ilindov/YarisSpeedDoorLock/RaspberryPi/_Schematic/IMG_0890.jpg

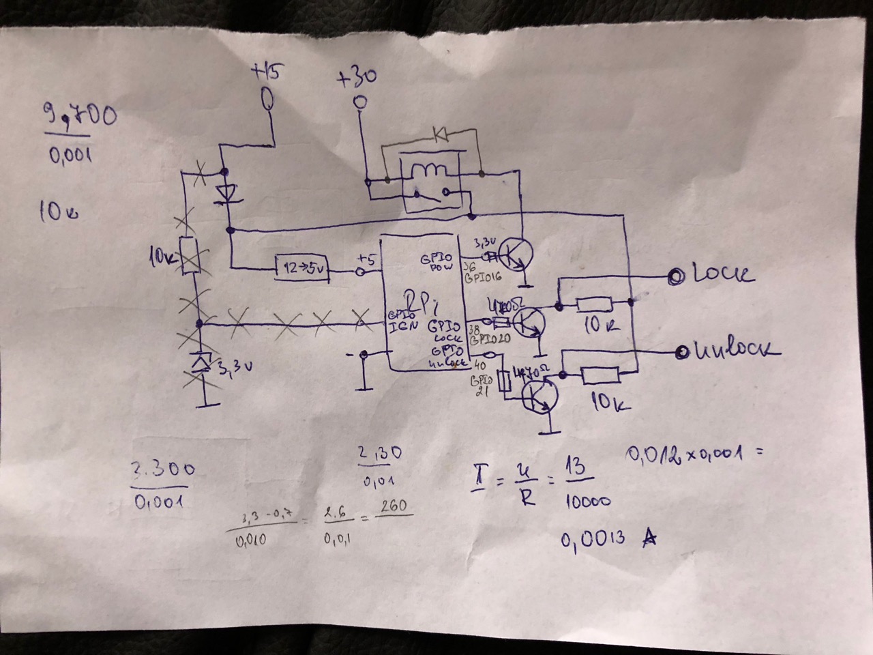
RaspberryPi/_Schematic/IMG_0890.jpg
