ilindov/YarisSpeedDoorLock/Arduino/YarisSpeedDoorLock/_Schematic&PCB/Yaris speed door lock-ext power and relays.brd

## EAGLE design Arduino/YarisSpeedDoorLock/_Schematic&PCB/Yaris speed door lock-ext power and relays.brd (2019-01-16)

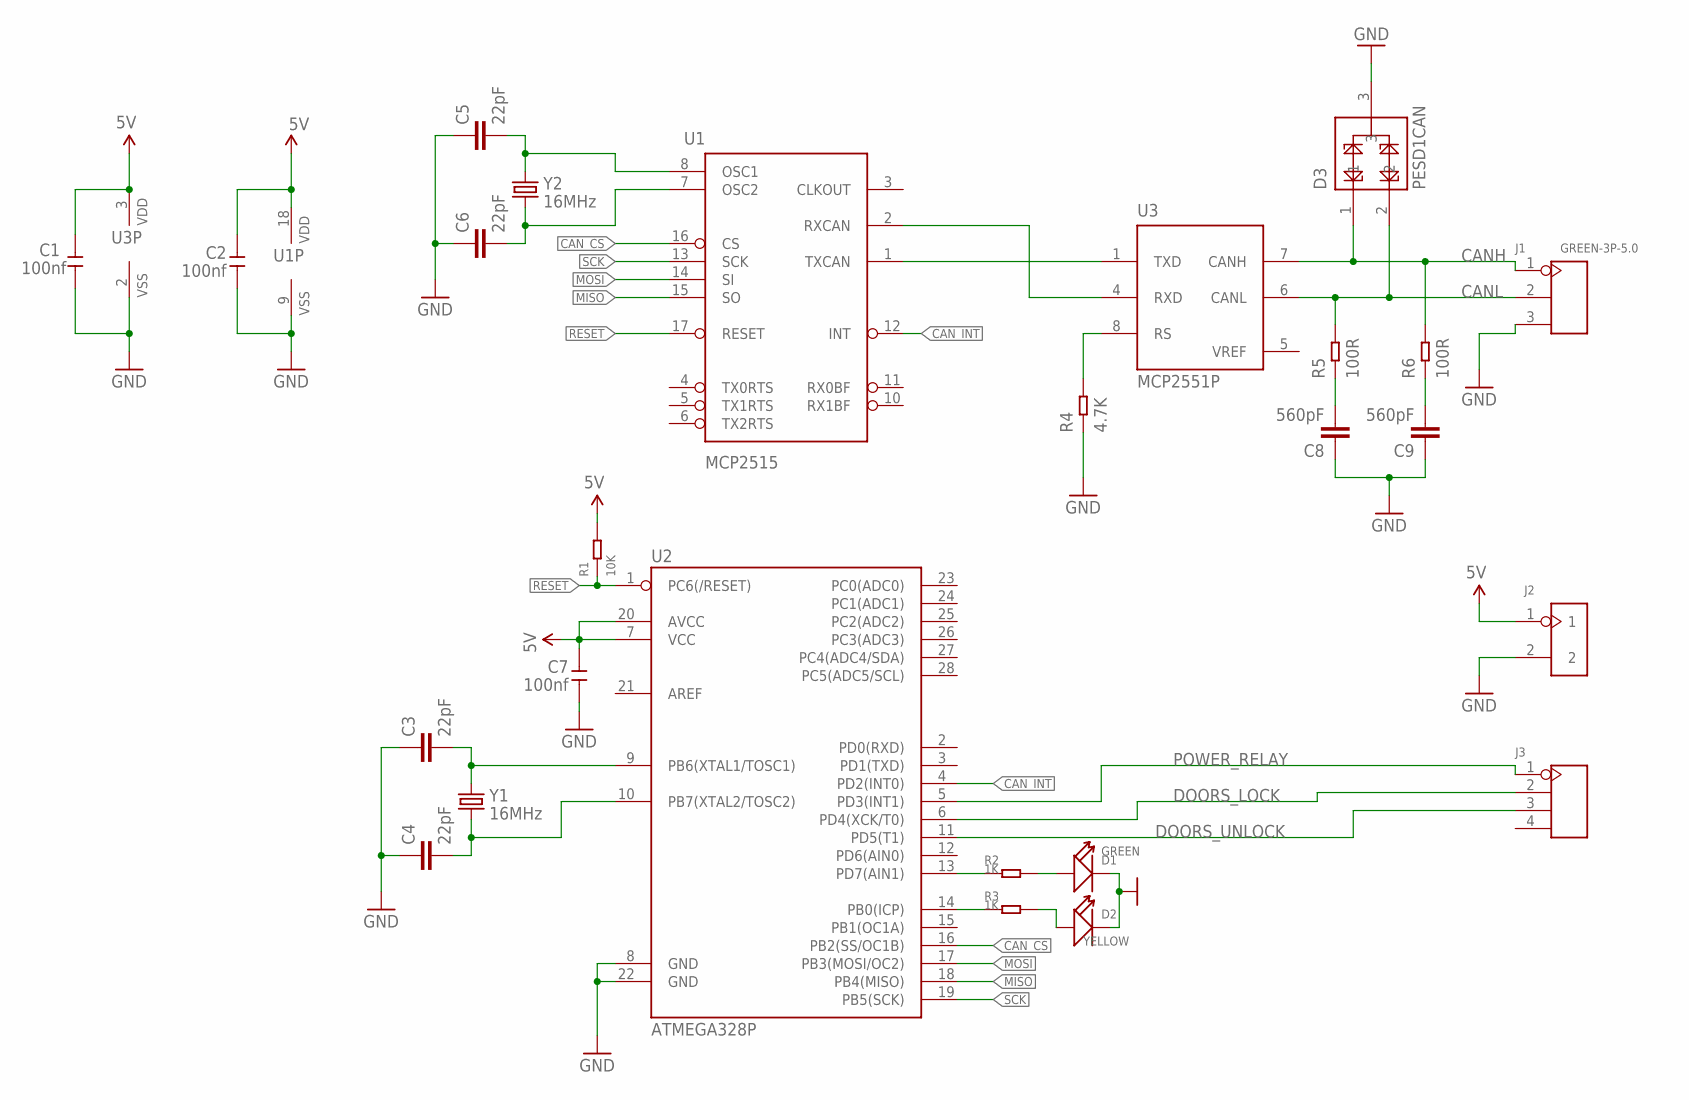
[picture p2: schematic Yaris speed door lock-ext power and relays.sch]

Parts:
C1, C2, C7: 100nf; CERAMIC-2.54
C3, C4, C5, C6: 22pF; CAP-PTH-2.54
C8, C9: 560pF; 0603-CAP
D1: GREEN; LED2-2.54-D3.0MM
D2: YELLOW; LED2-2.54-D3.0MM
D3: PESD1CAN; SOT23-3
J1: GREEN-3P-5.0; H3-5.0-15.5X8.0MM
J2: DIP-BLACK-JUMPER; H2-2.54
J3: DIP-BLACK-FEMALE-HEADER-VERT(4P-2.54); H4-2.54
R1: 10K; PR-D2.3XL6.5MM
R2, R3: 1K; PR-D2.3XL6.5MM
R4: 4.7K; PR-D2.3XL6.5MM
R5, R6: 100R; PR-D2.3XL6.5MM
U1: MCP2515; SO-18W
U2: ATMEGA328P; DIP28
U3: MCP2551P; DIL8
Y1, Y2: 16MHz; HC49US

Connections:
5V: C1.2, C2.2, C7.2, J2.1, R1.2, U1.18 (VDD), U2.7 (VCC), U2.20 (AVCC), U3.3 (VDD)
CANH: D3.1, J1.1, R6.2, U3.7 (CANH)
CANL: D3.2, J1.2, R5.2, U3.6 (CANL)
CAN_CS: U1.16 (CS), U2.16 (PB2(SS/OC1B))
CAN_INT: U1.12 (INT), U2.4 (PD2(INT0))
CAN_RXD: U1.2 (RXCAN), U3.4 (RXD)
CAN_TXD: U1.1 (TXCAN), U3.1 (TXD)
DOORS_LOCK: J3.2, U2.6 (PD4(XCK/T0))
DOORS_UNLOCK: J3.3, U2.11 (PD5(T1))
GND: C1.1, C2.1, C3.1, C4.1, C5.1, C6.1, C7.1, C8.1, C9.1, D1.K (-), D2.K (-), D3.3, J1.3, J2.2, R4.1, U1.9 (VSS), U2.8 (GND), U2.22 (GND), U3.2 (VSS)
MISO: U1.15 (SO), U2.18 (PB4(MISO))
MOSI: U1.14 (SI), U2.17 (PB3(MOSI/OC2))
unnamed: C3.2, U2.9 (PB6(XTAL1/TOSC1)), Y1.2
unnamed: C4.2, U2.10 (PB7(XTAL2/TOSC2)), Y1.1
unnamed: C8.2, R5.1
unnamed: C9.2, R6.1
unnamed: R2.1, U2.13 (PD7(AIN1))
unnamed: R4.2, U3.8 (RS)
unnamed: R3.1, U2.14 (PB0(ICP))
unnamed: D1.A (+), R2.2
unnamed: C5.2, U1.8 (OSC1), Y2.2
unnamed: C6.2, U1.7 (OSC2), Y2.1
unnamed: D2.A (+), R3.2
POWER_RELAY: J3.1, U2.5 (PD3(INT1))
RESET: R1.1, U1.17 (RESET), U2.1 (PC6(/RESET))
SCK: U1.13 (SCK), U2.19 (PB5(SCK))
VREF: U3.5 (VREF)

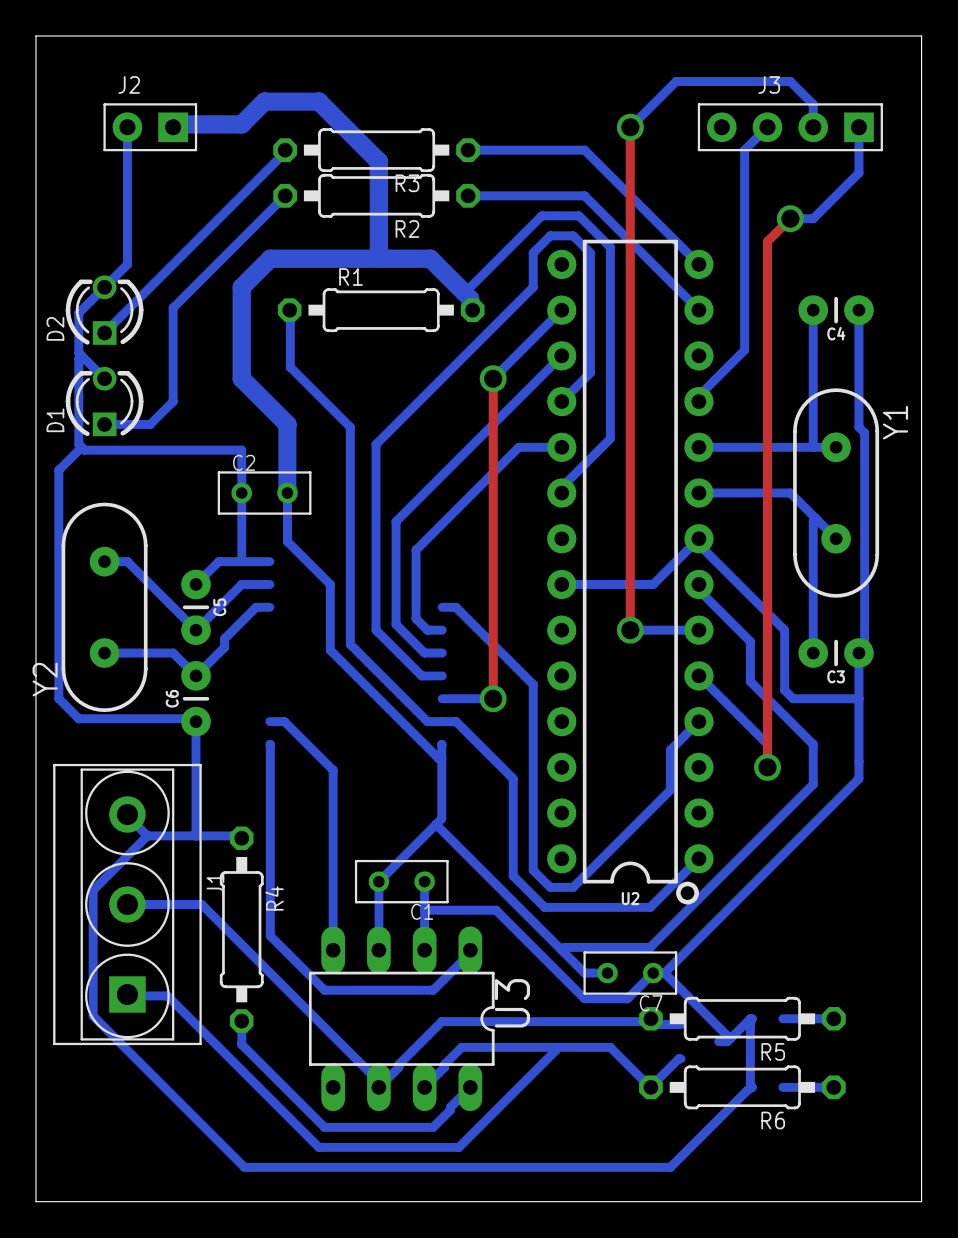
[picture p3: board Yaris speed door lock-ext power and relays.brd from above]

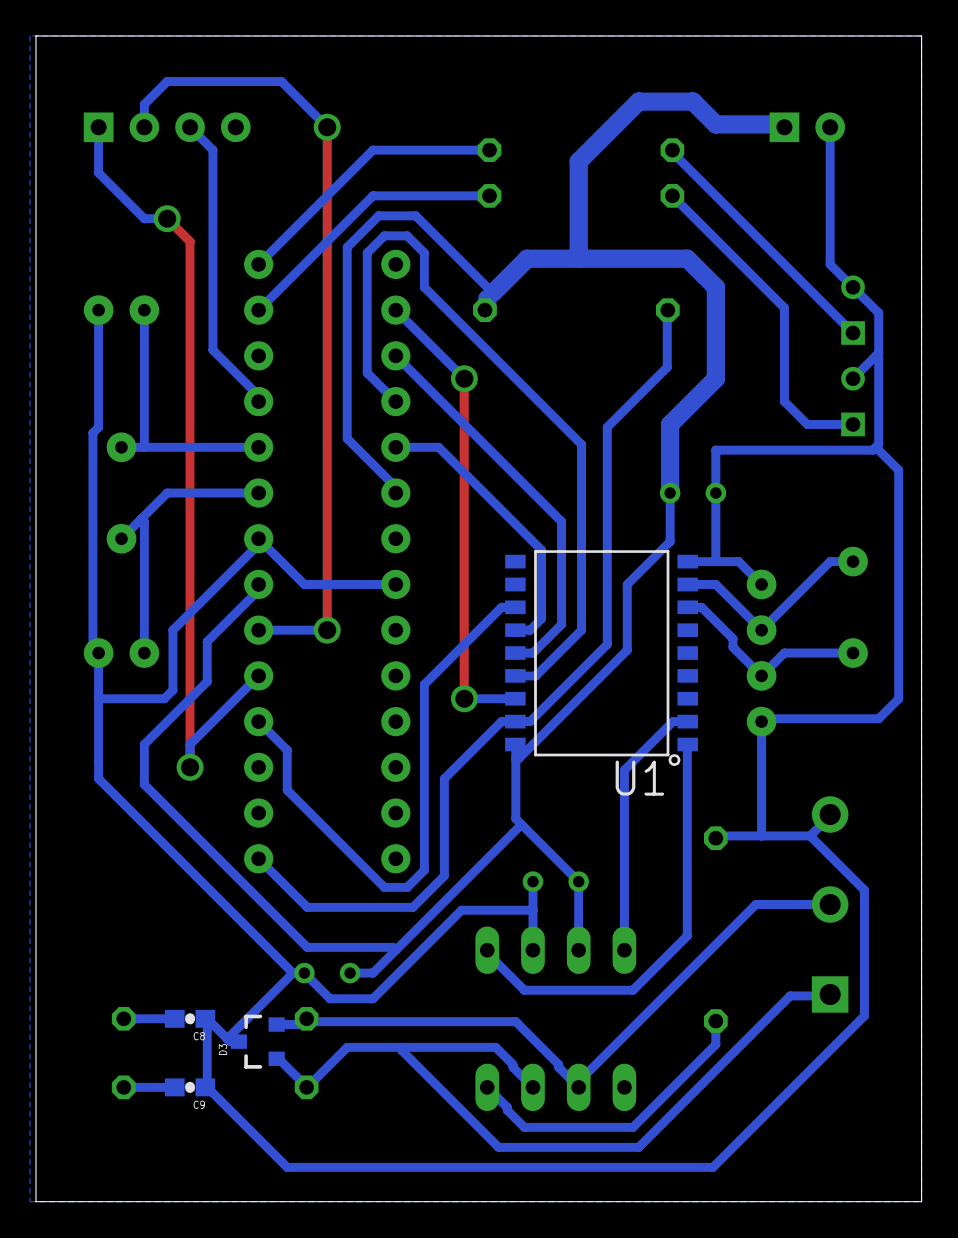
[picture p4: board Yaris speed door lock-ext power and relays.brd from below]

Board: 2 copper layers, 49.2 x 64.8 mm, 26 parts (4 on the bottom side), 26 nets.
