ilindov/YarisSpeedDoorLock/(commit log)

2019-01-03 Added schematic
2019-01-16 Initial Arduino
    [Yaris speed door lock-ext power and relays.brd, Yaris speed door lock-ext power and relays.sch, Yaris speed door lock.sch]
2019-01-17 Fixed pinout and changed halt logic
    [YarisSpeedDoorLock.h, YarisSpeedDoorLock.ino]
